CrematInc/CR-150-R4b/README.md

# CR-150-R4b
KiCad files for Cremat's CR-150-R4b, an evaluation board for Cremat's charge sensitive preamplifier modules CR-11X
Includes Schematic, layout, and gerber files. Also a BOM.
