CrematInc/CR-150-R4b/CR-150-R4b-Checkplot.gif

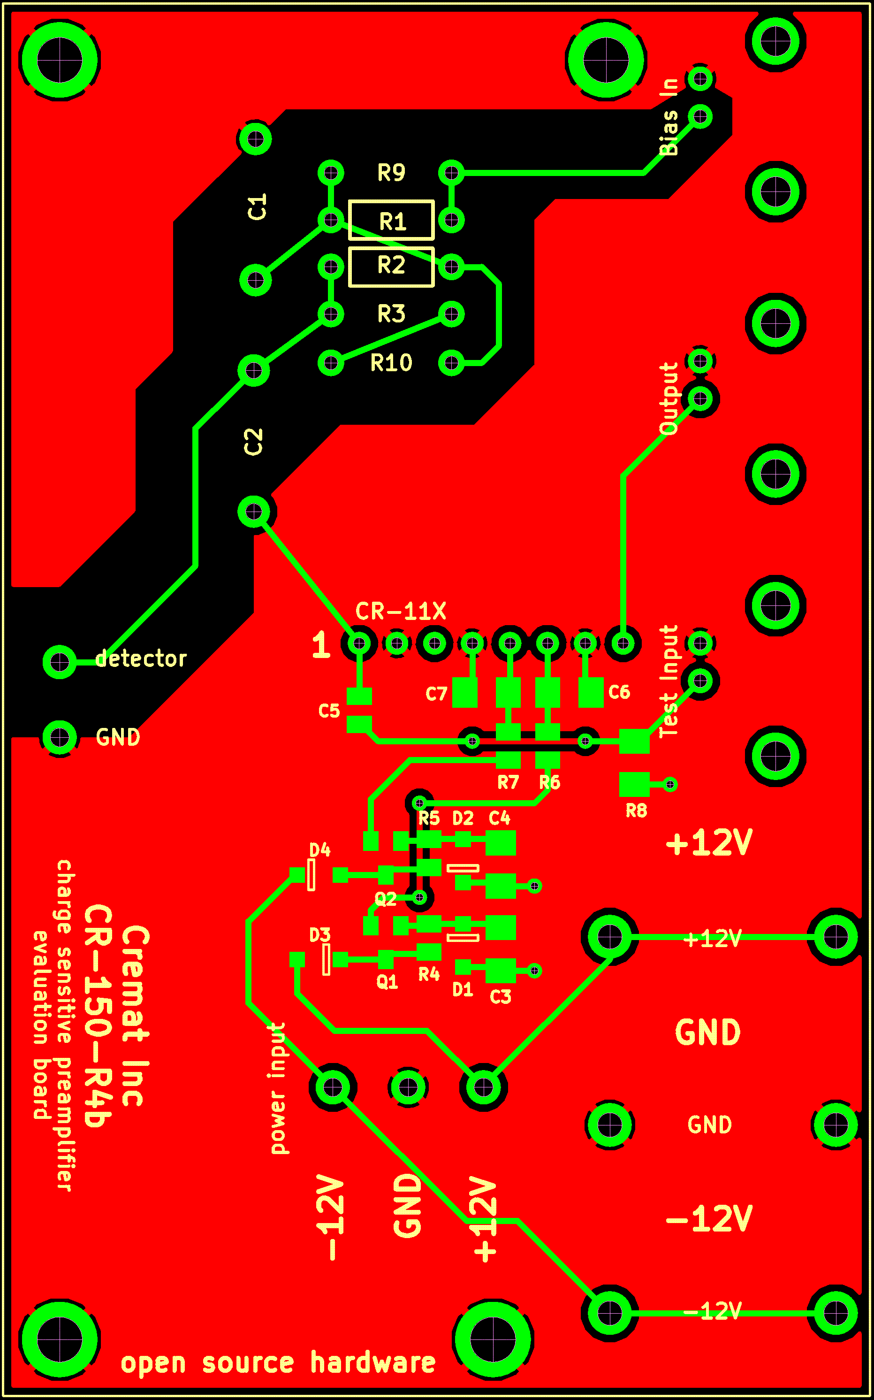
CR-150-R4b-Checkplot.gif
