CrematInc/CR-150-R4b/CR-150-R4b BOM.xls

Bill of Materials for CR-150-R4b
line |  |  | component
number | Reference | Value | footprint | supplier | part#
1 | R3,R10 | 100M | Thru-Hole RES 100M OHM 1/4W 5% AXIAL | Digi-key | A105971CT-ND
2 | R4,R5 | 2.2k | RES SMD 2.2K OHM 5% 1/8W 0805 | Digi-key | P2.2KATR-ND
3 | R6,R7 | 4.7 | RES SMD 4.7 OHM 5% 1/8W 0805 | Digi-key | P4.7ATR-ND
4 | R8 | 47 | RES SMD 47 OHM 5% 1/4W 1206 | Digi-key | P47ETR-ND
5 | R9 | 10M | Thru-Hole RES 10M OHM 1/4W 5% CARBON FILM | Digi-key | CF14JT10M0CT-ND
6 | Q1 | MMBT3904 | TRANS NPN 40V 0.2A SMD SOT23-3 | Digi-key | MMBT3904-FDITR-ND
7 | Q2 | MMBT3906 | TRANS PNP 40V 0.2A SOT23-3 | Digi-key | MMBT3906-FDITR-ND
8 | D1,D2 | 7.5V | DIODE ZENER 7.5V 200MW SOD323 | Digi-key | MM3Z7V5T1GOSTR-ND
9 | D3,D4 | 1N4148 | DIODE GEN PURP 75V 150MA SOD323 | Digi-key | 1N4148WS-FDITR-ND
10 | C1,C2 | 0.01uF | Ceramic Disc Capacitors .01uF 3Kvolts 20% .375LS Y5V | Mouser | 75-564R30GASS10
11 | C3,C4,C6,C7 | 10uF | CAP CER 10UF 25V 10% X5R 1206 | Digi-key | 1276-1075-2-ND
12 | C5 | 1pF | CAP CER 1PF 50V NPO 0805 | DigiKey | 311-1089-2-ND
13 | J2,J3,J4 | boardmount BNC | BNC connector JACK PCB STD bulkhead | Mouser | 538-73138-5033
14 | J5 | 3-terminal block | Fixed Terminal Blocks 5.0MM PCB MOUNT 3P | Mouser | 571-2828363
15 | J6,J7,J8 | boardmount banana | boardmount banana, 4mm socket | Mouser | 164-6218
