CrematInc/CR-150-R4b/CR-150-R4b schematic.pdf

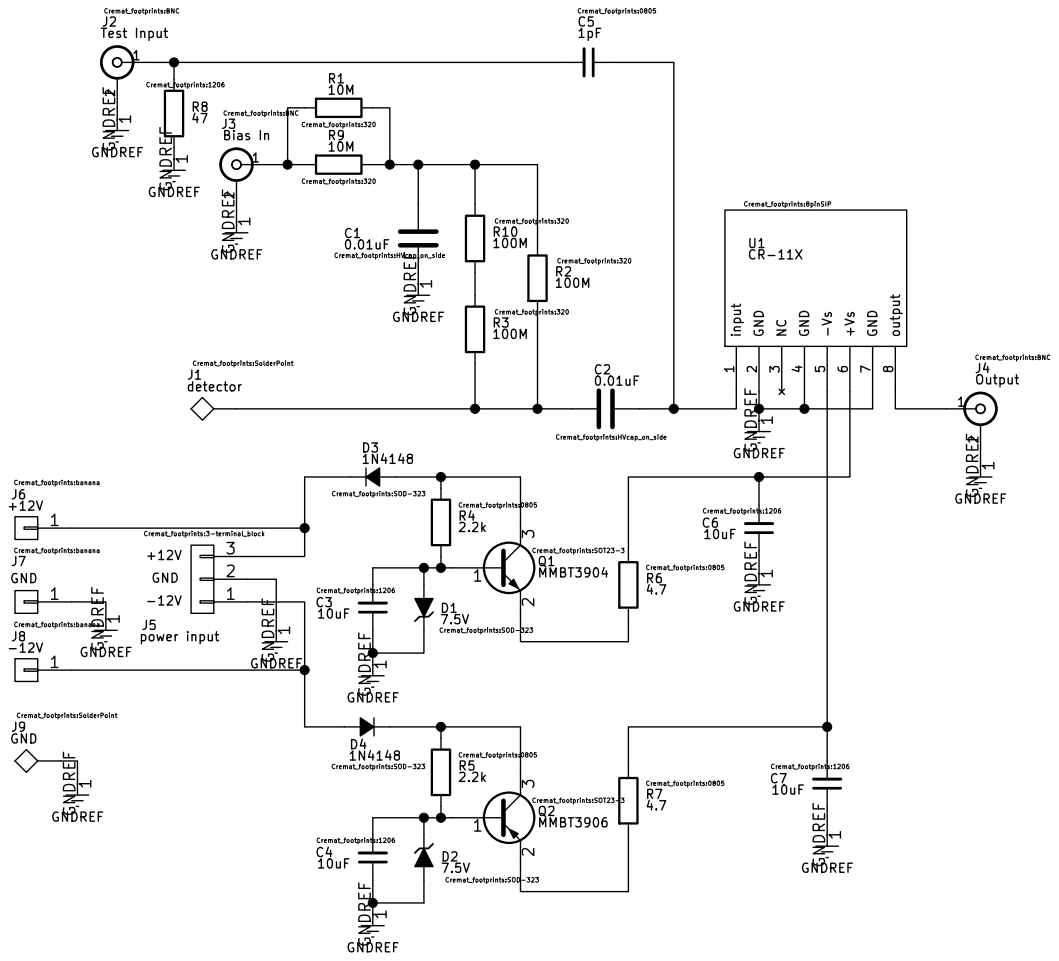
[picture p2: page 1]
