CrematInc/CR-150-R4b/CR-150-R4b.kicad_pcb

## KiCad design CR-150-R4b.kicad_pcb (2015-11-23)

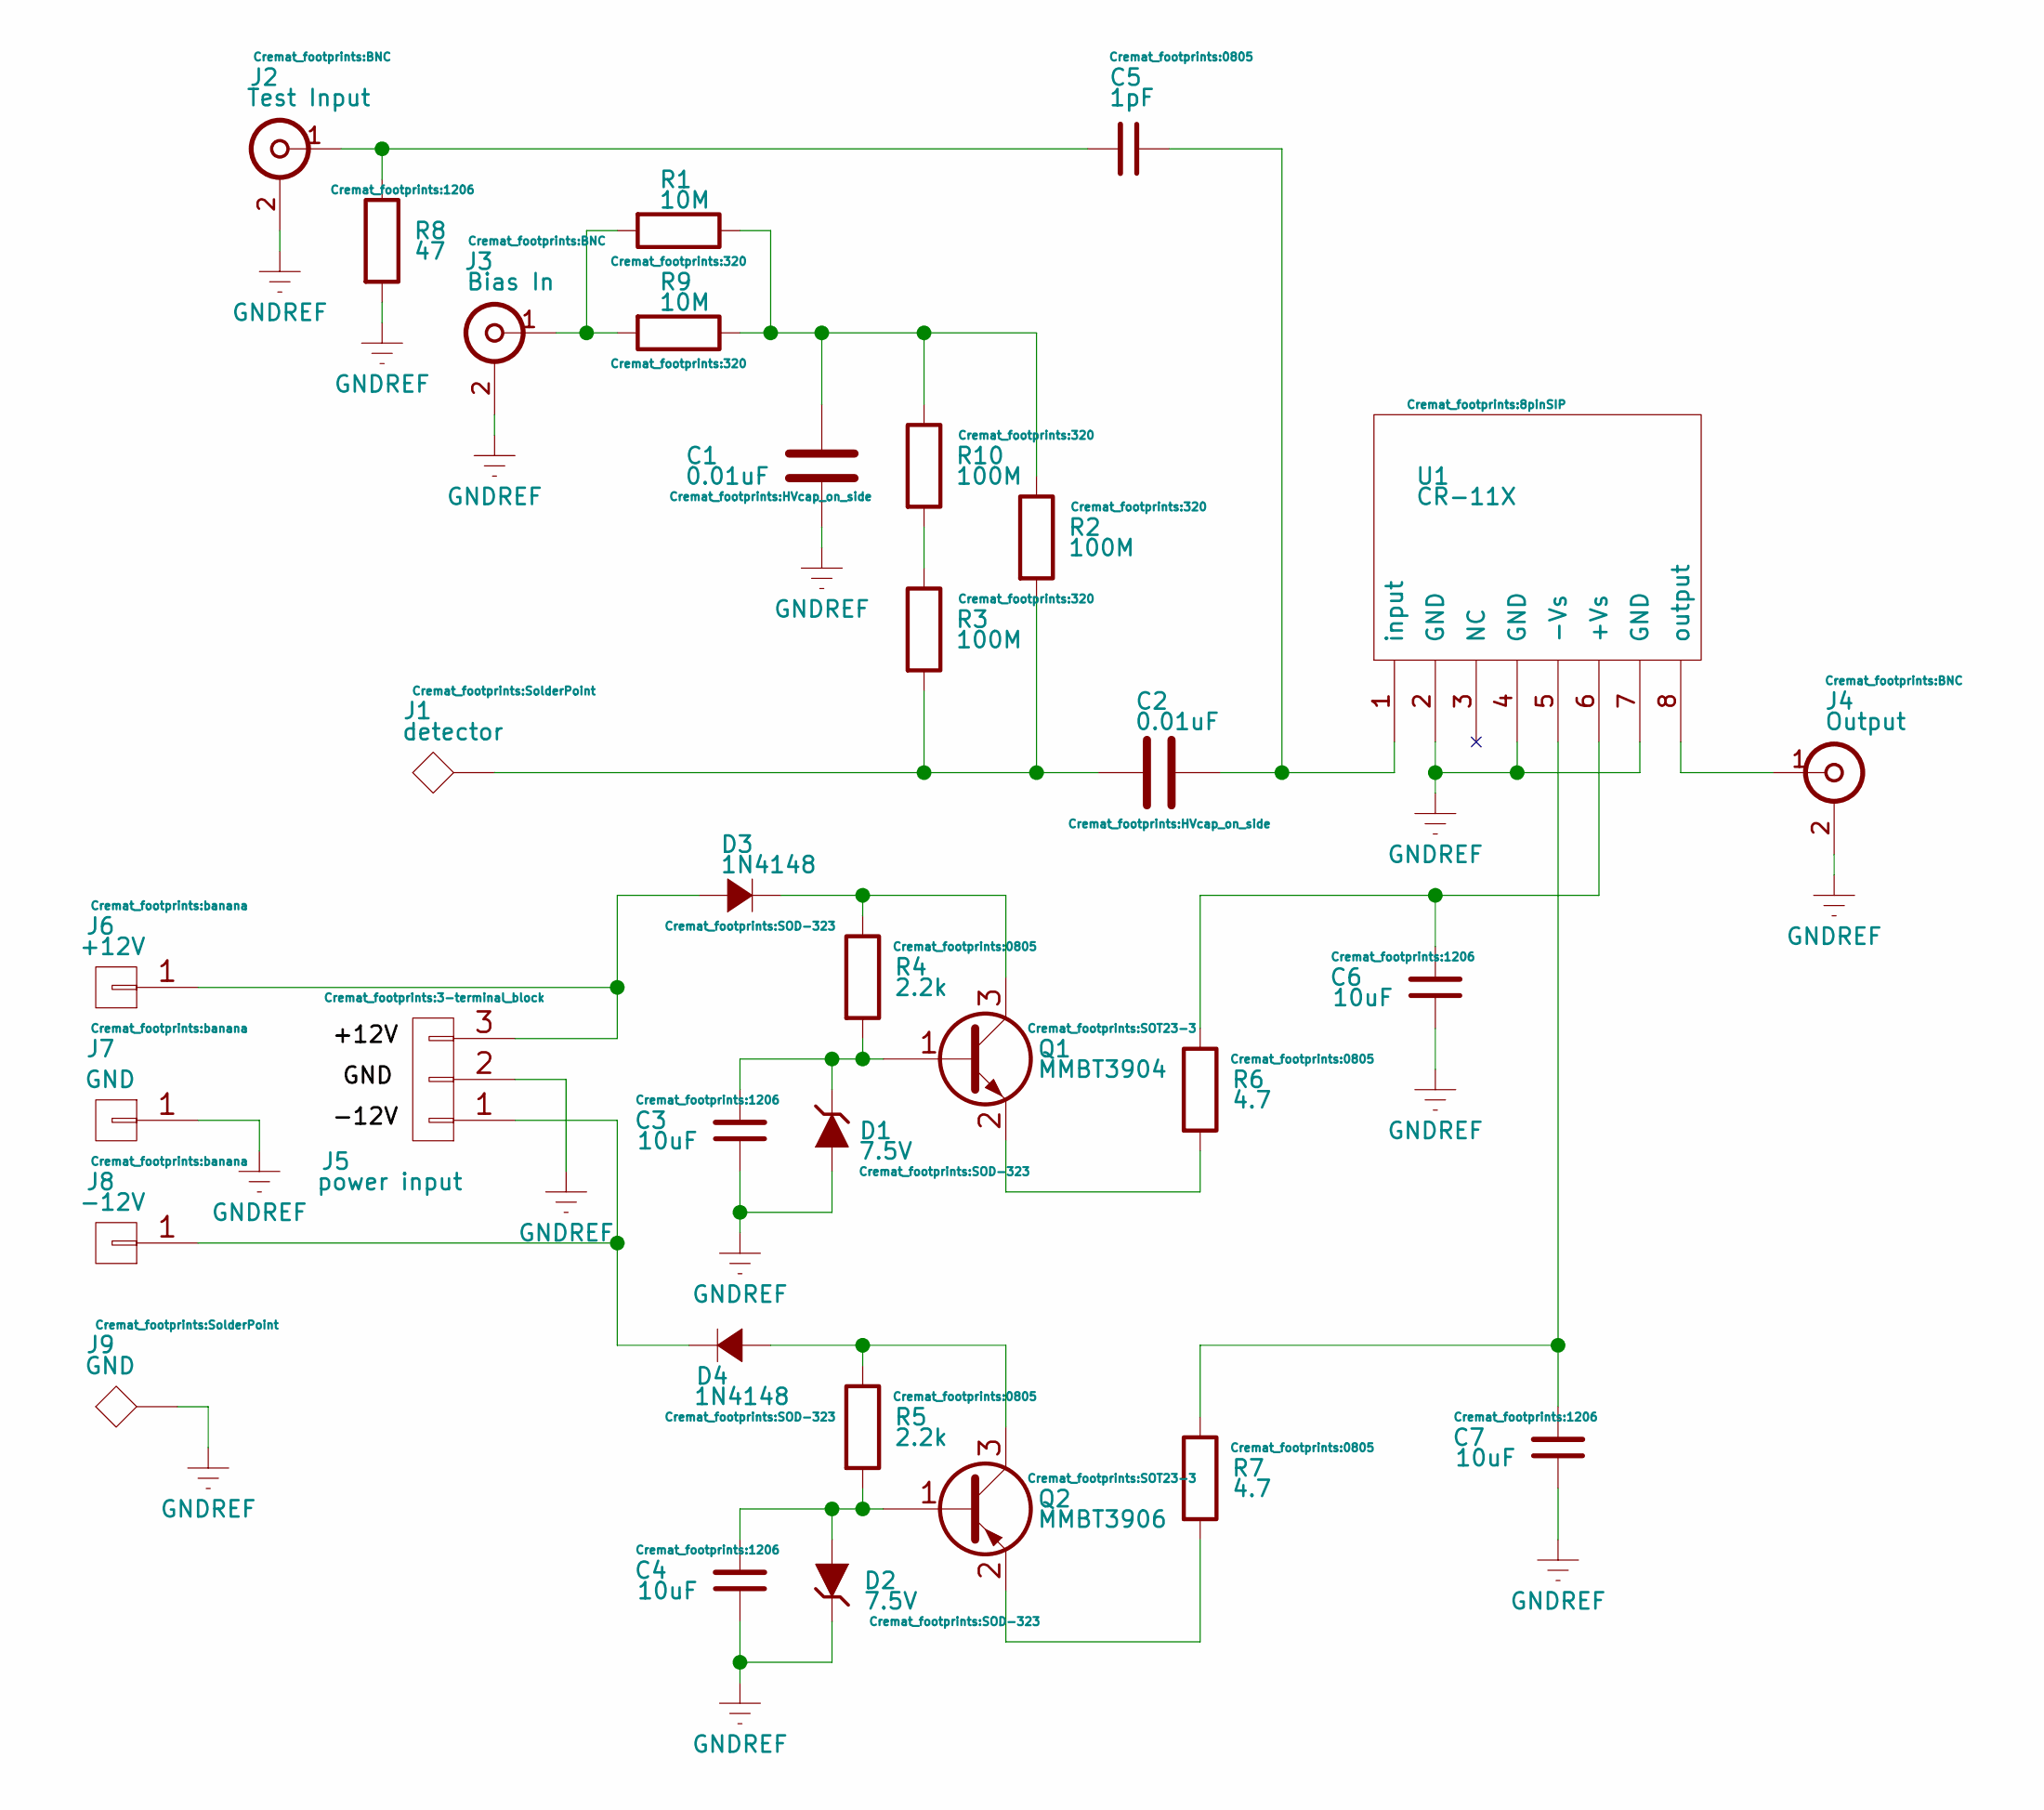
[picture p3: schematic CR-150-R4b.sch, CR-150-R4b evaluation board for Cremat CR-11X modules]

Parts:
C1, C2: 0.01uF; HVcap_on_side
C3, C4, C6, C7: 10uF; 1206
C5: 1pF; 0805
D1, D2: 7.5V; SOD-323
D3, D4: 1N4148; SOD-323
J1: detector; SolderPoint
J2: Test Input; BNC
J3: Bias In; BNC
J4: Output; BNC
J5: power input; 3-terminal_block
J6: +12V; banana
J7: GND; banana
J8: -12V; banana
J9: GND; SolderPoint
Q1: MMBT3904; SOT23-3
Q2: MMBT3906; SOT23-3
R1, R9: 10M; 320
R2, R3, R10: 100M; 320
R4, R5: 2.2k; 0805
R6, R7: 4.7; 0805
R8: 47; 1206
U1: CR-11X; 8pinSIP

Connections:
GNDREF: C1.1, C3.1, C4.1, C6.1, C7.1, D1.1 (A), D2.2 (K), J2.2 (Ext), J3.2 (Ext), J4.2 (Ext), J5.2, J7.1, J9.1, R8.2, U1.2 (GND), U1.4 (GND), U1.7 (GND)
unnamed: C1.2, R1.1, R2.1, R9.1, R10.1
unnamed: C2.1, J1.1, R2.2, R3.2
unnamed: C2.2, C5.1, U1.1 (input)
unnamed: C3.2, D1.2 (K), Q1.1 (B), R4.2
unnamed: C4.2, D2.1 (A), Q2.1 (B), R5.2
unnamed: C5.2, J2.1 (In), R8.1
unnamed: C6.2, R6.1, U1.6 (+Vs)
unnamed: C7.2, R7.1, U1.5 (-Vs)
unnamed: D3.1 (A), J5.3, J6.1
unnamed: D3.2 (C), Q1.3 (C), R4.1
unnamed: D4.1 (A), Q2.3 (C), R5.1
unnamed: D4.2 (C), J5.1, J8.1
unnamed: J3.1 (In), R1.2, R9.2
unnamed: J4.1 (In), U1.8 (output)
unnamed: Q1.2 (E), R6.2
unnamed: Q2.2 (E), R7.2
unnamed: R3.1, R10.2

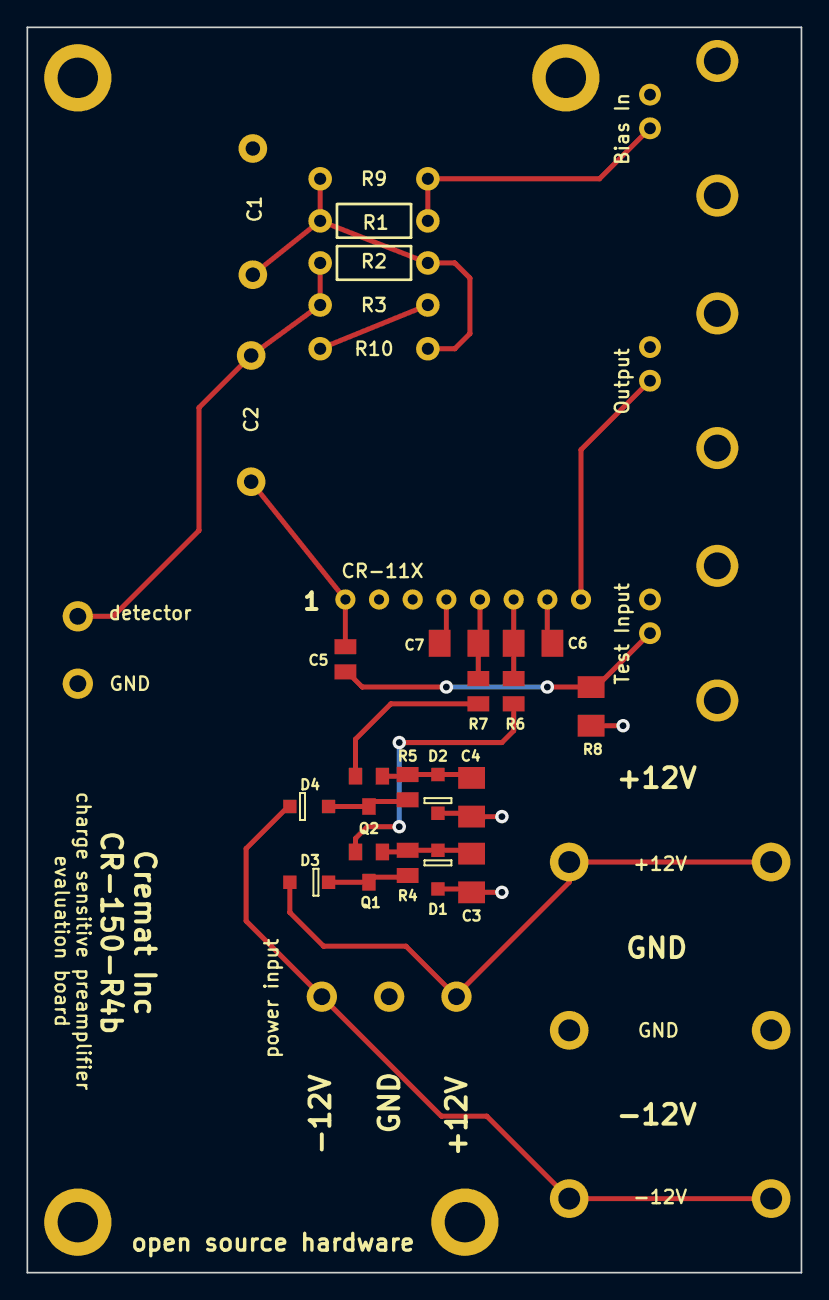
[picture p4: board CR-150-R4b.kicad_pcb from above]

Board: 2 copper layers, 58.4 x 94.0 mm, 33 parts (0 on the bottom side), 18 nets.
