CrematInc/CR-150-R4b/(notices)

Notices in the files:
CR-150-R4b.sch:
This is Open Source Hardware under the MIT license. http://opensource.org/licenses/MIT
